scrotumLab/x0x/SL27 Scrotum Lab x0x - Pacemaker-rev2.0 schematics.png

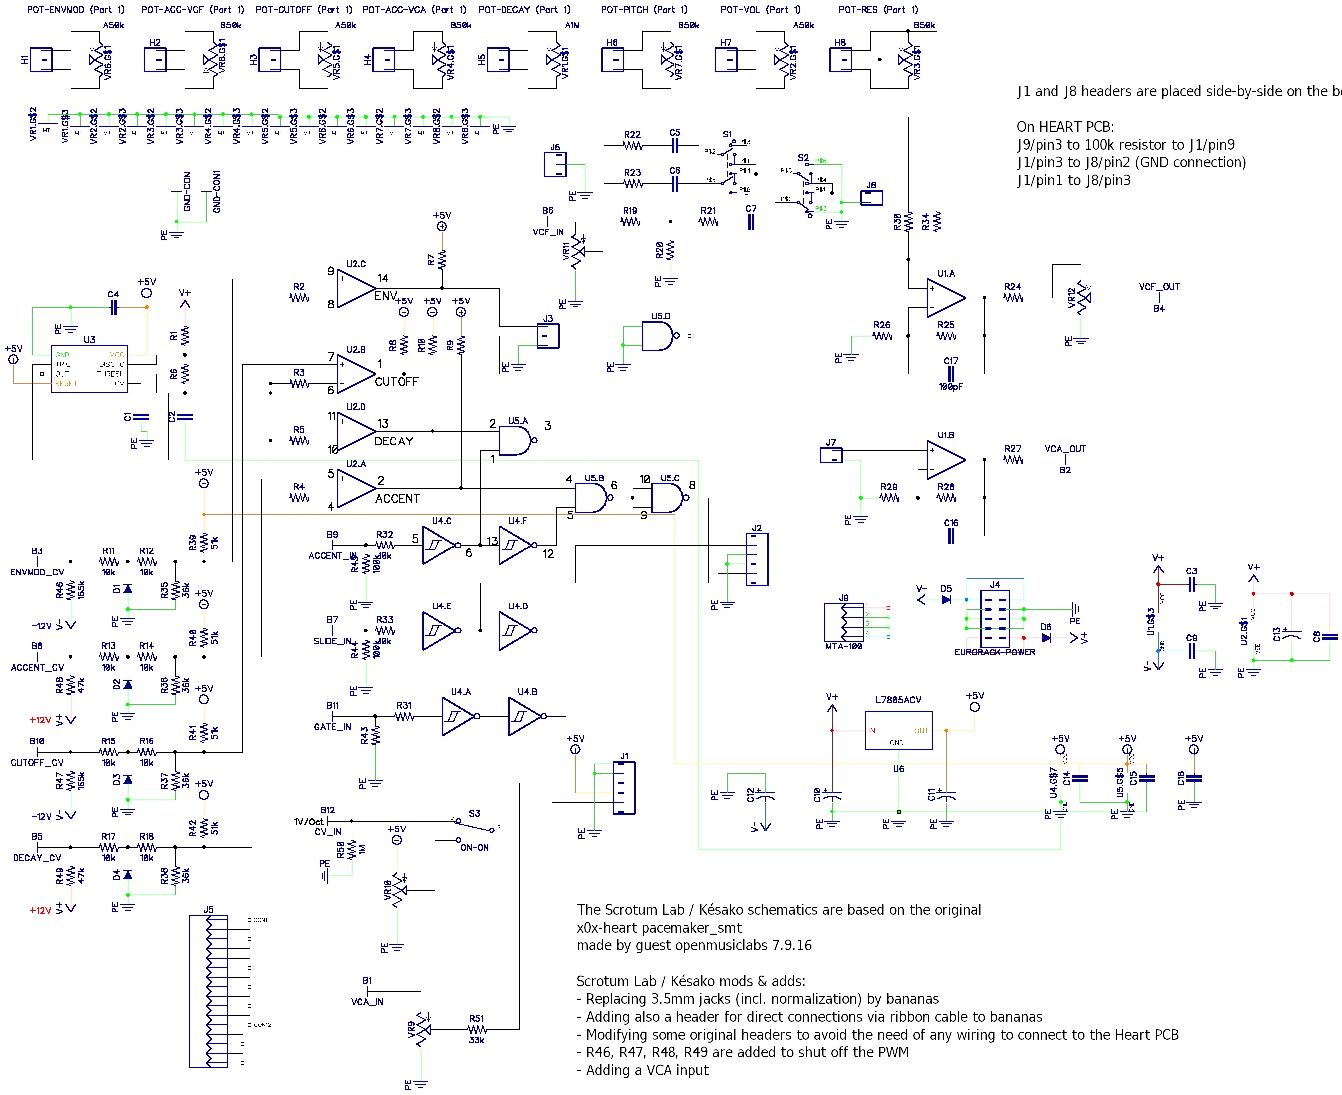
SL27 Scrotum Lab x0x - Pacemaker-rev2.0 schematics.png
