scrotumLab/x0x/(list of files, drawings)

Other design files:
SL27 Scrotum Lab x0x - Pacemaker-rev2.0.dch
SL27 Scrotum Lab x0x - Pacemaker-rev2.0.dip
