scrotumLab/x0x/(commit log)

2021-12-22 Schematics in Diptrace
    [SL27 Scrotum Lab x0x - Pacemaker-rev2.0.dch]
2021-12-22 PCB in Diptrace
    [SL27 Scrotum Lab x0x - Pacemaker-rev2.0.dip]
2021-12-22 GERBER files
2021-12-22 PCB layout in Diptrace
    [SL27 Scrotum Lab x0x - Pacemaker-rev2.0.dip]
2021-12-22 BOM for rev 2.0
2021-12-22 Schematics as PNG file for preview
